sky4walk/BrausteuerungV3/BackEnd/Dokumente/BrausteuerungV3Plan.jpg

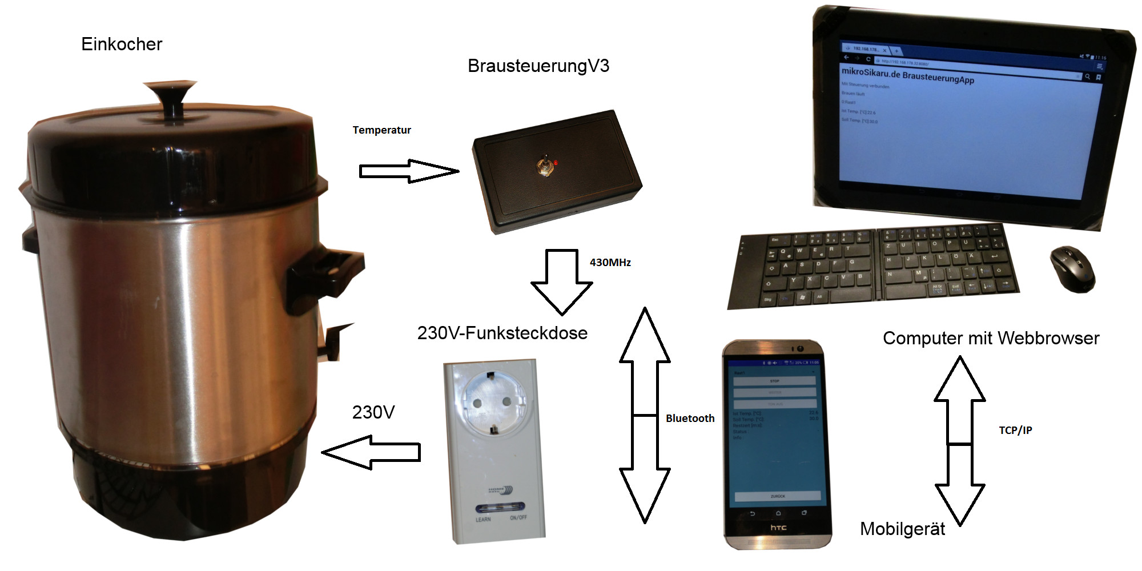
BackEnd/Dokumente/BrausteuerungV3Plan.jpg
