sky4walk/BrausteuerungV3/README.md

# BrausteuerungV3
mikroSikaru.de

brausteuerung@AndreBetz.de
 
more Information found on 
https://zwieselbrau.wordpress.com/2016/03/30/mikrosikaru-brausteuerung-v3-bluetooth/

Video Tutorial
https://zwieselbrau.wordpress.com/2017/05/13/mikrosikaru-brausteuerung-v3-bedienung-videoanleitung/

Android App in Playstore:
https://play.google.com/store/apps/details?id=de.mikrosikaru.brausteuerungapp
