sky4walk/BrausteuerungV3/FrontEnd/Android/Dokumente/Information.odt

Lieber Kunde,

vielen Dank für den Erwerb der mikroSikaru Brausteuerung V3.

Damit Sie die Brausteuerung zufriedenstellend verwenden können, ist ein Blick in die Anleitung unumgänglich. Diese ist unter der Webseite brausteuerung.com verfügbar.

Zum Betrieb der Brausteuerung ist eine App für Android Mobilgeräte notwendig. Der Link zu der App befindet sich auch unter dem Link brausteuerung.com.

Bitte beachten Sie unbedingt auch die Anleitung ihres Android Mobilgerätes, insbesondere zur Herstellung einer Bluetooth-Verbindung.

Bei Fragen und Problemen wenden Sie sich bitte an support@mikroSikaru.de .

Mit freundlichen Grüssen

André Betz
