sky4walk/BrausteuerungV3/BackEnd/Typenschild/Typenschild.pdf

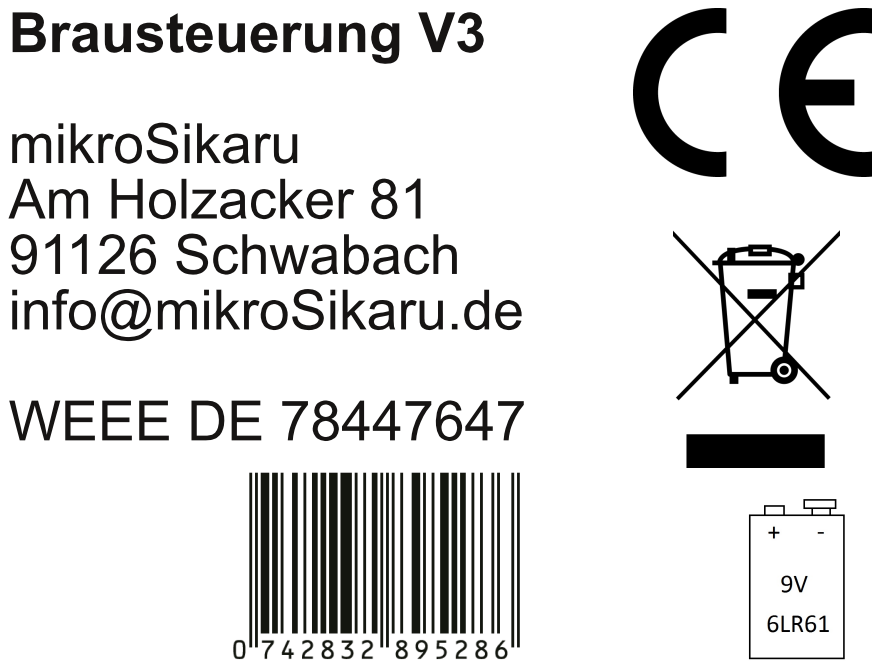
[picture p14: page 1]
