sky4walk/BrausteuerungV3/BackEnd/Arduino/Hardware/Brausteuerung_Steckplatine.png

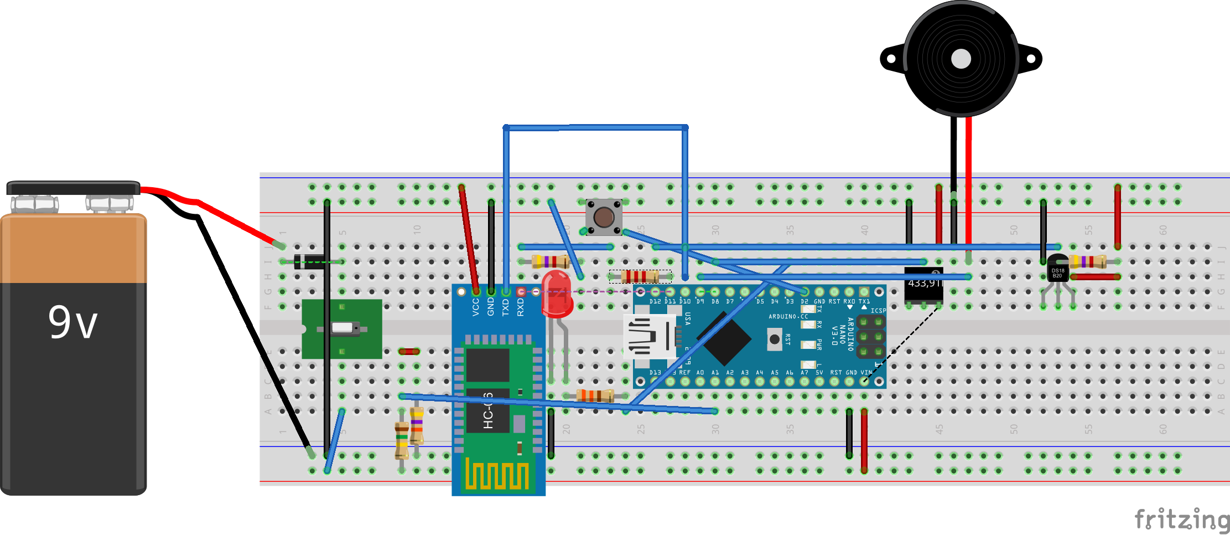
BackEnd/Arduino/Hardware/Brausteuerung_Steckplatine.png
