sky4walk/BrausteuerungV3/BackEnd/Box/BrausteuerungBox.png

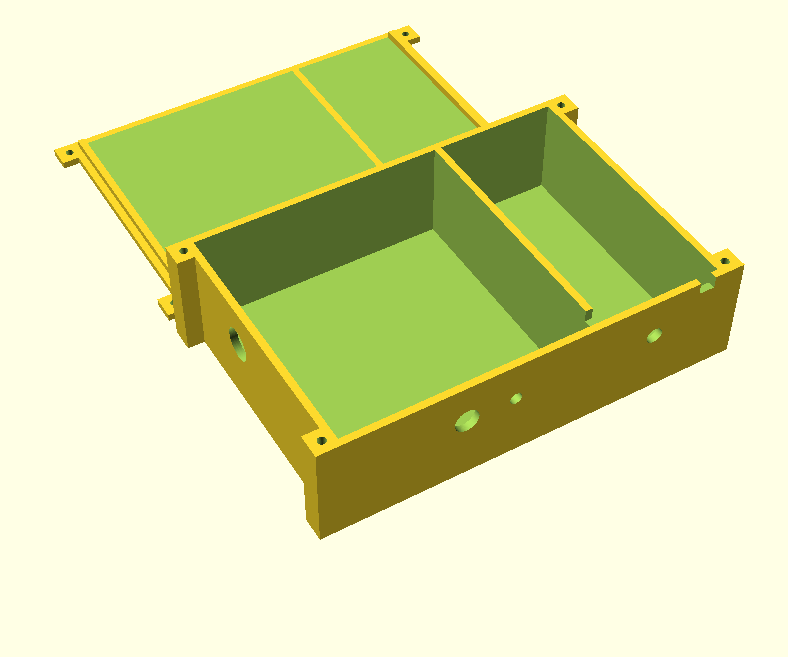
BackEnd/Box/BrausteuerungBox.png
