sky4walk/BrausteuerungV3/BackEnd/KiCad/Elecrow-KicadGerber.png

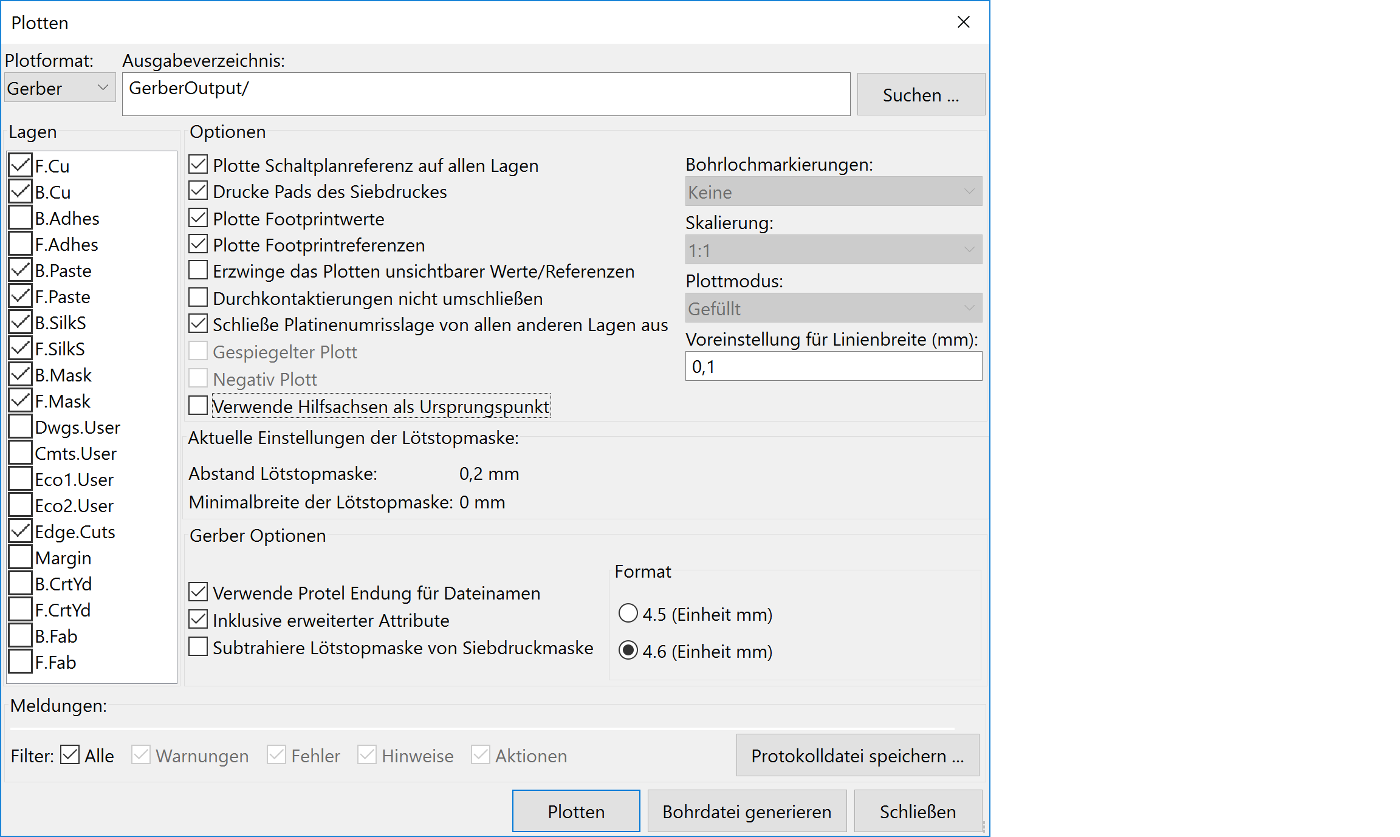
BackEnd/KiCad/Elecrow-KicadGerber.png
