sky4walk/BrausteuerungV3/BackEnd/KiCad/Elecrow-KicadGerberDrill.png

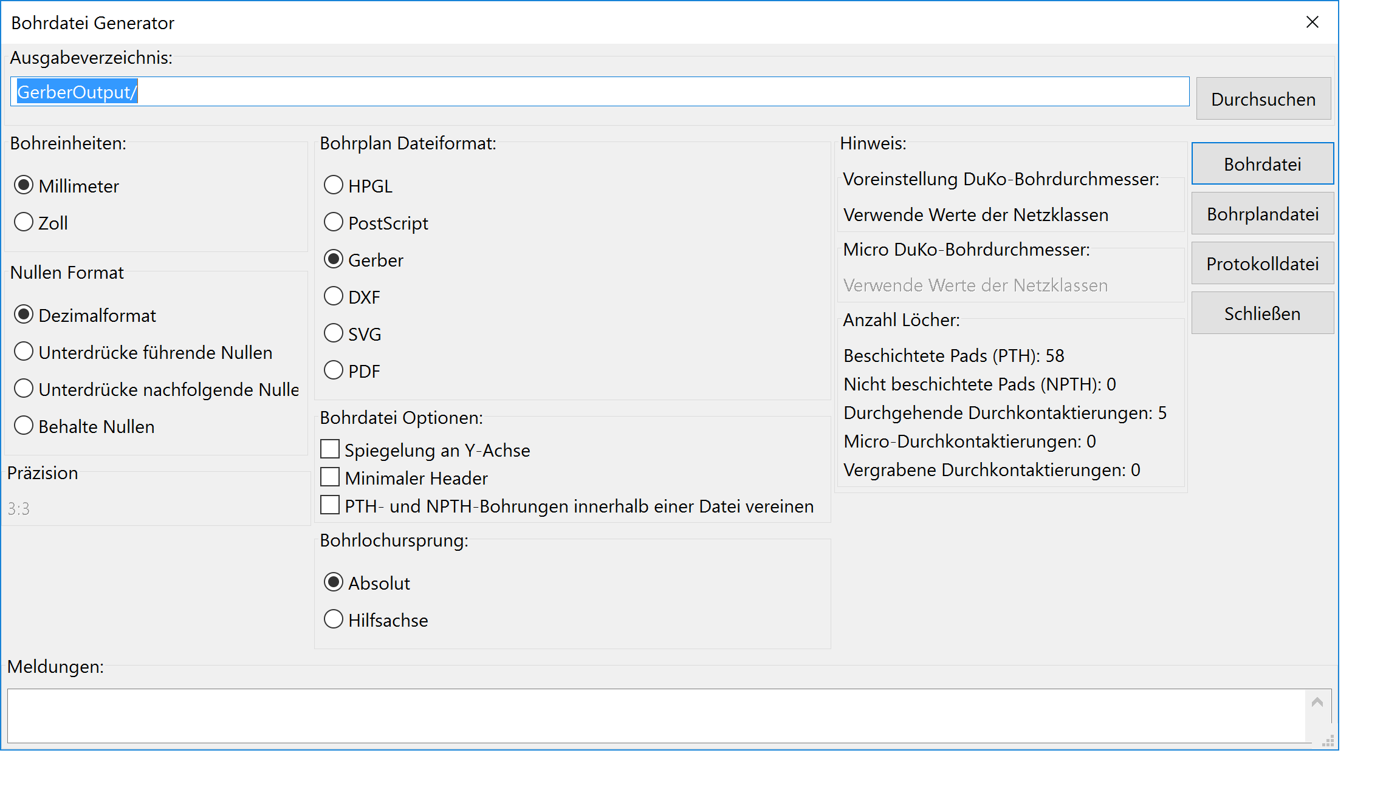
BackEnd/KiCad/Elecrow-KicadGerberDrill.png
