sky4walk/BrausteuerungV3/BackEnd/Typenschild/9VBattery.png

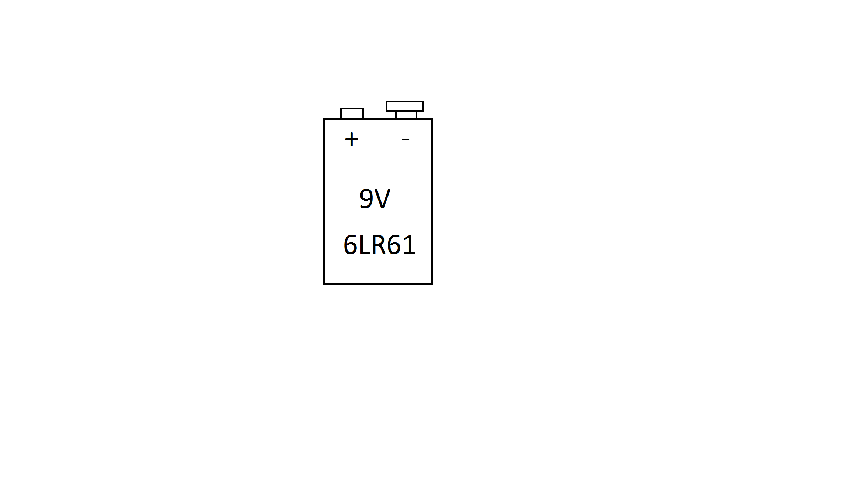
BackEnd/Typenschild/9VBattery.png
