sky4walk/BrausteuerungV3/BackEnd/Typenschild/CE.png

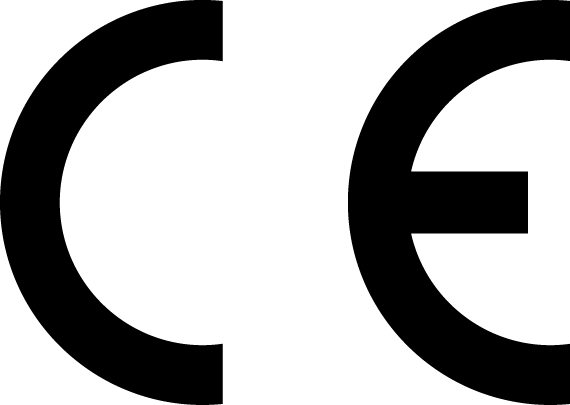
BackEnd/Typenschild/CE.png
