sky4walk/BrausteuerungV3/BackEnd/Typenschild/Muelltonne1.png

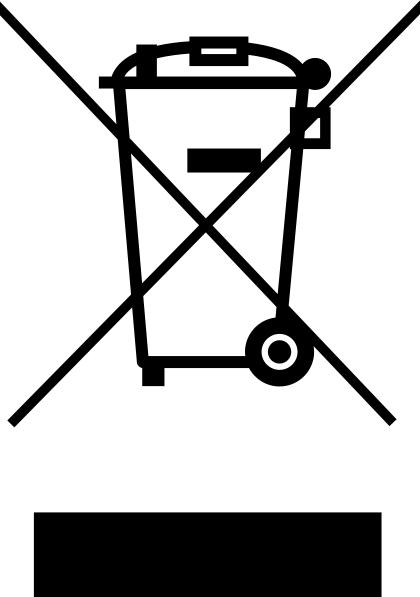
BackEnd/Typenschild/Muelltonne1.png
