sky4walk/BrausteuerungV3/BackEnd/Dokumente/Preisliste.ods

Sheet: Sheet1
Anzahl benötigt | Bezeichnung | Anbieter | Enthalten | Preis komplett | Versandkosten | Versandkosten anteilig | Preis benötigt | Preis mit Versand |  | Bestellung 7.6.16
1 | Arduino Nano | https://www.amazon.de/gp/product/B01BN1C54S/ref=oh_aui_detailpage_o07_s00?ie=UTF8&psc=1 | 5 | 17,97 | 0 | 0 | 3,594 | 3,594
1 | Bluetooth HC-06 | https://www.amazon.de/gp/product/B00GAXG9A6/ref=oh_aui_detailpage_o00_s00?ie=UTF8&psc=1 | 1 | 5,44 | 0 | 0 | 5,44 | 5,44
1 | Transmitter 433MHz | http://www.amazon.de/gp/product/B010SR8J4I?psc=1&redirect=true&ref_=oh_aui_detailpage_o09_s00 | 5 | 6,99 | 0 | 0 | 1,398 | 1,398
1 | DS18B20 wasserdicht 2Meter | https://www.amazon.de/Temperaturfuehler-Wasserdicht-Digital-Temperatur-DS18b20/dp/B01CTXWYVI | 10 | 18,85 | 0 | 0 | 1,885 | 1,885
1 | Piezzo Buzzer | http://www.amazon.de/gp/product/B00J4BK0NS?psc=1&redirect=true&ref_=oh_aui_detailpage_o00_s00 | 20 | 5,21 | 0 | 0 | 0,2605 | 0,2605
1 | Gehäuse KEMO GEH KSB 01B 101x60x26 (G01B 9V) | https://www.reichelt.de/index.html?ACTION=3;ARTICLE=73220;SEARCH=GEH%20KSB%2001B | 1 | 1,65 | 4,99 | 4,99 | 1,65 | 6,64
1 | 9V Batterieclip | http://www.amazon.de/gp/product/B00HUH9IWM | 20 | 2,65 | 0 | 0 | 0,1325 | 0,1325
1 | Widerstand 150kOhm BatterieSPannungsteiler | https://www.amazon.de/gp/product/B00I9YY6GS/ref=ox_sc_act_title_2?ie=UTF8&psc=1&smid=A18RZZ15309PCR | 20 | 1,29 | 1,99 | 0,0995 | 0,0645 | 0,164
1 | Widerstand 47kOhm BatterieSPannungsteiler | https://www.amazon.de/Widerstand-St%C3%BCck-Metallschicht-Metallfilm-Widerst%C3%A4nde/dp/B00I8SDDXW (https://www.amazon.de/Widerstand-Stück-Metallschicht-Metallfilm-Widerstände/dp/B00I8SDDXW) | 20 | 1,29 | 0 | 0 | 0,0645 | 0,0645
1 | Widerstand 330Ohm on off led | https://www.amazon.de/gp/product/B00I8NOICW/ref=ox_sc_act_title_1?ie=UTF8&psc=1&smid=A18RZZ15309PCR | 30 | 1,29 | 0 | 0 | 0,043 | 0,043
1 | Widerstand 4,7KOhm DS18B20 | http://www.amazon.de/Widerstand-St%C3%BCck-Metallschicht-Metallfilm-Widerst%C3%A4nde/dp/B00I8NOOEY | 20 | 1,29 | 0 | 0 | 0,0645 | 0,0645
1 | 1N5817 DO-41 Schottky-Gleichrichter-Dioden 20V 1A (https://www.amazon.de/gp/product/B01EZZMSKA/ref=oh_aui_detailpage_o00_s00?ie=UTF8&psc=1) | https://www.amazon.de/gp/css/order-history/ref=nav_youraccount_orders | 80 | 5,73 | 2 | 0,025 | 0,071625 | 0,096625
1 | Mini Kipp Schalter | https://www.amazon.de/gp/product/B00R1LKWCM/ref=ox_sc_act_title_1?ie=UTF8&psc=1&smid=A3JWKAKR8XB7XF | 100 | 16,07 | 0 | 0 | 0,1607 | 0,1607
1 | Home Easy Funkschaltsteckdosen HE808S | http://www.amazon.de/gp/product/B006H0XNFQ?psc=1&redirect=true&ref_=oh_aui_detailpage_o05_s00 | 3 | 31,45 | 0 | 0 | 10,4833333333333 | 10,4833333333333
1 | 10 x Kabeldurchführungstülle, Gummitülle, Kabeltülle, Kabelschutz, KD: 4mm ID: 6,2mm | https://www.amazon.de/10-Kabeldurchf%C3%BChrungst%C3%BClle-Gummit%C3%BClle-Kabelt%C3%BClle-Kabelschutz/dp/B00P8ZUQ8I | 10 | 1,99 | 2,5 | 0,25 | 0,199 | 0,449
0,1 | Sekundenkleber | http://www.amazon.de/gp/product/B00M94A20I?keywords=sekundenkleber&qid=1449411101&ref_=sr_ph&sr=1 | 5 | 2,79 | 1 | 0,02 | 0,0558 | 0,2558
0,002 | Draht schwarz (keine versandkosten schon oben) | http://www.amazon.de/Farbige-Kupferschaltlitze-Isolierung-1adrig-Farbe/dp/B0019R2WFE?s=diy | 10 | 3,03 | 0 | 0 | 0,000606 | 0,000606
0,002 | Draht rot (keine versandkoste schon oben drin) | http://www.amazon.de/Farbige-Kupferschaltlitze-Isolierung-1adrig-Farbe/dp/B0019R2WFE?s=diy | 10 | 3,03 | 0 | 0 | 0,000606 | 0,100606
0,1 | Lötzinn | http://www.amazon.de/Silverline-AS15-L%C3%B6tzinn-100-g/dp/B000LFTN1G?s=diy | 100 | 4,73 | 0 | 0 | 0,00473 | 0,00473
1 | LED als Power on indikator | http://www.amazon.de/Green-Yellow-Assorted-Emitting-Diodes/dp/B0087ZT1VO | 75 | 2,35 | 0 | 0 | 0,0313333333333 | 0,0313333333333
1 | DIP-4 Drucktaster 6x6x5mm DC12V 50mA | https://www.amazon.de/gp/product/B00D82M9LA/ref=oh_aui_search_detailpage?ie=UTF8&psc=1 | 100 | 1,28 | 1 | 0,01 | 0,0128 | 0,0228
0,001 | Isolierband - Länge 25mt. - Breite 15mm. - Schwarz | https://www.amazon.de/Isolierband-L%C3%A4nge-25mt-Breite-Schwarz/dp/B00EAQPH2Q?s=diy | 25 | 4,4 | 0 | 0 | 0,000176 | 0,000176
1 | Platine | elecrow.com | 10 | 14 | 8 | 0,8 | 1,4 | 2,2
1 | Typenschild | Wir-machen-druck.de | 75 | 12,9 | 3,9 | 0,052 | 0,172 | 0,224
33,33 | Papier (Rechnung+Bedienungsanleitung + Versandetikett) | https://www.amazon.de/Hewlett-Packard-CHP350-Laserpapier-HP-Colour-Laser-Blatt/dp/B000H80CXA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 | 500 | 8,66 | 0 | 0 | 0,5772756 | 0,5772756
1 | Versand DHL Versichert 2kg | dhl.de | 1 | 4,99 | 0 | 0 | 4,99 | 4,99
 | Summe |  |  |  | 25,38 | 6,2465 | 32,7564852666667 | 39,2829852666667
 | Kosten ProfiCook |  |  |  |  |  |  | 9,7103753333333
 |  |  |  |  |  |  |  |  | 0
 |  |  |  |  |  |  |  |  | 0
Aufbauschritte | Zeiten (min)
Bauteile darauflöten | 10
Bohren Gehäuse | 5
Zusammenbau Gehäuse | 10
Verpacken | 12
einstellen / einlernen / testen | 10
Summe | 47

Sheet: Blatt1
Anzahl benötigt | Bezeichnung | Anbieter | Enthalten | Preis komplett | Versandkosten | Versandkosten anteilig | Preis benötigt | Preis mit Versand
0 | Arduino Nano | http://www.amazon.de/gp/product/B013EEPAE4?psc=1&redirect=true&ref_=oh_aui_detailpage_o06_s00 | 5 | 15,23 | 1,99 | 0 | 0 | 0,398
1 | Bluetooth HC-06 | http://www.amazon.de/EasyWordMall-Bluetooth-Transceiver-Wireless-Arduino/dp/B00VJACCP6?s=computers | 1 | 5,59 | 0 | 0 | 5,59 | 5,59
1 | Transmitter 433MHz | http://www.amazon.de/gp/product/B010SR8J4I?psc=1&redirect=true&ref_=oh_aui_detailpage_o09_s00 | 5 | 5,99 | 0 | 0 | 1,198 | 1,198
0 | Piezzo Buzzer | http://www.amazon.de/gp/product/B00J4BK0NS?psc=1&redirect=true&ref_=oh_aui_detailpage_o00_s00 | 20 | 5,21 | 0 | 0 | 0 | 0
1 | Gehäuse KEMO GEH KSB 01B 101x60x26 (G01B 9V) | https://www.reichelt.de/index.html?ACTION=3;ARTICLE=73220;SEARCH=GEH%20KSB%2001B | 1 | 1,65 | 4,99 | 4,99 | 1,65 | 6,64
0 | 9V Batterieclip | http://www.amazon.de/gp/product/B00HUH9IWM | 20 | 2,65 | 0 | 0 | 0 | 0
0 | Widerstand 100kOhm BatterieSPannungsteiler | http://www.amazon.de/Widerstand-St%C3%BCck-Metallschicht-Metallfilm-Widerst%C3%A4nde/dp/B00I8SHUE0 | 20 | 1,29 | 1,99 | 0 | 0 | 0,0995
0 | Widerstand 330Ohm on off led | http://www.amazon.de/Widerstand-St%C3%BCck-Kohleschicht-Widerst%C3%A4nde-Resistor/dp/B00IYT10JY | 30 | 2,29 | 0 | 0 | 0 | 0
1 | Schalter | http://www.amazon.de/SODIAL-Stueck-125V-Amps-Position/dp/B00IIDY49E | 10 | 3,41 | 0 | 0 | 0,341 | 0,341
1 | Kabeldurchführungstülle, Gummitülle, Kabeltülle, Kabelschutz, KD: 3,2mm ID: 4,8mm | http://www.amazon.de/gp/product/B00P8ZTF1M?psc=1&redirect=true&ref_=oh_aui_detailpage_o01_s00 | 10 | 1,99 | 2,5 | 0,25 | 0,199 | 0,449
0 | Sekundenkleber | http://www.amazon.de/gp/product/B00M94A20I?keywords=sekundenkleber&qid=1449411101&ref_=sr_ph&sr=1 | 5 | 2,79 | 1 | 0 | 0 | 0,2
0 | Draht blau | http://www.amazon.de/Farbige-Kupferschaltlitze-Isolierung-1adrig-Farbe/dp/B0019R2WFE?s=diy | 10 | 3,03 | 2,9 | 0 | 0 | 0,29
0 | Draht schwarz (keine versandkosten schon oben) | http://www.amazon.de/Farbige-Kupferschaltlitze-Isolierung-1adrig-Farbe/dp/B0019R2WFE?s=diy | 10 | 3,03 | 0 | 0 | 0 | 0
0 | Draht rot (keine versandkoste schon oben drin) | http://www.amazon.de/Farbige-Kupferschaltlitze-Isolierung-1adrig-Farbe/dp/B0019R2WFE?s=diy | 10 | 3,03 | 0 | 0 | 0 | 0,29
0 | Lötzinn | http://www.amazon.de/Silverline-AS15-L%C3%B6tzinn-100-g/dp/B000LFTN1G?s=diy | 100 | 4,73 | 0 | 0 | 0 | 0
0 | LED als Power on indikator | http://www.amazon.de/Green-Yellow-Assorted-Emitting-Diodes/dp/B0087ZT1VO | 75 | 2,35 | 0 | 0 | 0 | 0
1 | 7x9cm Lochrasterplatte Leiterplatte Streifenraster Platine | https://www.amazon.de/7x9cm-Lochrasterplatte-Leiterplatte-Streifenraster-Platine/dp/B00HV51YIY | 10 | 4 | 0,99 | 0,099 | 0,4 | 0,499
0 | DIP-4 Drucktaster | https://www.amazon.de/gp/product/B00D82M9LA/ref=oh_aui_search_detailpage?ie=UTF8&psc=1 | 100 | 1,28 | 1 | 0 | 0 | 0,01
 | doppelseitiges klebeband
 | isolierband
 | Summe |  |  |  | 17,36 | 5,339 | 9,378 | 16,0045
0 | DS18B20 wasserdicht 3Meter | http://www.amazon.de/gp/product/B00EU5U182?psc=1&redirect=true&ref_=oh_aui_detailpage_o01_s00 | 5 | 15,99 | 0,99 | 0 | 0 | 0,198
0 | Widerstand 4,7KOhm DS18B20 | http://www.amazon.de/Widerstand-St%C3%BCck-Metallschicht-Metallfilm-Widerst%C3%A4nde/dp/B00I8NOOEY | 20 | 1,29 | 0 | 0 | 0 | 0
1 | NTC 10k 3470 | http://www.amazon.de/gp/product/B00ORLCZ8I?psc=1&redirect=true&ref_=oh_aui_detailpage_o05_s00 | 10 | 6,25 | 0 | 0 | 0,625 | 0,625
1 | Widerstand 10kOHm NTC | http://www.amazon.de/Widerstand-St%C3%BCck-Metallschicht-Metallfilm-Widerst%C3%A4nde/dp/B00I8N88MS | 20 | 1,29 | 0 | 0 | 0,0645 | 0,0645
1 | Home Easy Funkschaltsteckdosen HE808S | http://www.amazon.de/gp/product/B006H0XNFQ?psc=1&redirect=true&ref_=oh_aui_detailpage_o05_s00 | 3 | 30 | 0 | 0 | 10 | 10
 | Kosten NTC |  |  |  |  |  |  | 26,694
 | Kosten DS18B20 |  |  |  |  |  |  | 26,2025
 | Kosten ProfiCook |  |  |  |  |  |  | 7,077

Sheet: Tabelle3
Anzahl benötigt | Bezeichnung | Anbieter | Enthalten | Preis komplett | Versandkosten | Versandkosten anteilig | Preis benötigt | Preis mit Versand |  |  | Bestellung 7.6.16
1 | Arduino Nano | https://www.amazon.de/gp/product/B015MGHH6Q/ref=oh_aui_detailpage_o03_s00?ie=UTF8&psc=1 | 5 | 16,99 | 0 | 0 | 3,398 | 3,398 | Produkthaftpflicht jährlich | 295
1 | Bluetooth HC-06 | https://www.amazon.de/Bluetooth-Sendeempfaenger-Modul-drahtlose-serielle/dp/B01DXFA6GQ | 1 | 4,56 | 0 | 0 | 4,56 | 4,56 | WEEE | 350
1 | Transmitter 433MHz | https://www.amazon.de/XCSOURCE-Transmitter-Receiver-Arduino-TE122/dp/B00V4ISS38 | 5 | 6,89 | 0 | 0 | 1,378 | 1,378 |  | 645
1 | DS18B20 wasserdicht 2Meter | https://www.amazon.de/Temperaturfuehler-Wasserdicht-Digital-Temperatur-DS18b20/dp/B01CTXWYVI | 10 | 19,66 | 0 | 0 | 1,966 | 1,966
1 | Piezzo Buzzer 3V , d=12mm, Dicke=9,6mm | http://www.amazon.de/gp/product/B00J4BK0NS?psc=1&redirect=true&ref_=oh_aui_detailpage_o00_s00 | 20 | 5,21 | 0 | 0 | 0,2605 | 0,2605
1 | Gehäuse KEMO GEH KSB 01B 101x60x26 (G01B 9V) | https://www.reichelt.de/index.html?ACTION=3;ARTICLE=73220;SEARCH=GEH%20KSB%2001B | 30 | 1,65 | 4,99 | 0,1663333333333 | 0,055 | 0,2213333333333
1 | 9V Batterieclip | http://www.amazon.de/gp/product/B00HUH9IWM | 20 | 2,65 | 0 | 0 | 0,1325 | 0,1325
1 | Widerstand 150kOhm BatterieSPannungsteiler | https://www.amazon.de/gp/product/B00I9YY6GS/ref=ox_sc_act_title_2?ie=UTF8&psc=1&smid=A18RZZ15309PCR | 20 | 1,29 | 1,99 | 0,0995 | 0,0645 | 0,164
1 | Widerstand 47kOhm BatterieSPannungsteiler | https://www.amazon.de/Widerstand-St%C3%BCck-Metallschicht-Metallfilm-Widerst%C3%A4nde/dp/B00I8SDDXW (https://www.amazon.de/Widerstand-Stück-Metallschicht-Metallfilm-Widerstände/dp/B00I8SDDXW) | 20 | 1,29 | 0 | 0 | 0,0645 | 0,0645
1 | Widerstand 330Ohm on off led | https://www.amazon.de/gp/product/B00I8NOICW/ref=ox_sc_act_title_1?ie=UTF8&psc=1&smid=A18RZZ15309PCR | 30 | 1,29 | 0 | 0 | 0,043 | 0,043
2 | Widerstand 4,7KOhm DS18B20 | http://www.amazon.de/Widerstand-St%C3%BCck-Metallschicht-Metallfilm-Widerst%C3%A4nde/dp/B00I8NOOEY | 20 | 1,29 | 0 | 0 | 0,129 | 0,129
1 | Widerstand 2,2KOhm HC06 RX | https://www.amazon.de/gp/product/B00SWKCU62/ref=ox_sc_act_title_1?smid=A50DZI580G3JX&psc=1 | 30 | 3,68 | 0 | 0 | 0,1226666666667 | 0,1226666666667
1 | 1N5817 DO-41 Schottky-Gleichrichter-Dioden 20V 1A (https://www.amazon.de/gp/product/B01EZZMSKA/ref=oh_aui_detailpage_o00_s00?ie=UTF8&psc=1) | https://www.amazon.de/gp/css/order-history/ref=nav_youraccount_orders | 80 | 5,73 | 2 | 0,025 | 0,071625 | 0,096625
1 | 10 x Kippschalter mit 2 Positionen, AC, 125 V / 3 A 2.8 x 1.2 x 0.5cm / 1.1 "x 0.5" x 0.2 "(L * B * H) (https://www.amazon.de/gp/product/B00HGAKDIQ/ref=oh_aui_detailpage_o01_s00?ie=UTF8&psc=1) | https://www.amazon.de/gp/product/B00HGAKDIQ/ref=oh_aui_detailpage_o01_s00?ie=UTF8&psc=1 | 10 | 5,09 | 0 | 0 | 0,509 | 0,509
1 | Arendo - Funksteckdosen-Set (3+1) | https://www.amazon.de/gp/product/B01GQFJVC0/ref=oh_aui_detailpage_o04_s00?ie=UTF8&psc=1 | 3 | 16,85 | 0 | 0 | 5,6166666666667 | 5,6166666666667
1 | 10 x Kabeldurchführungstülle, Gummitülle, Kabeltülle, Kabelschutz, KD: 4mm ID: 6,2mm | https://www.amazon.de/10-Kabeldurchf%C3%BChrungst%C3%BClle-Gummit%C3%BClle-Kabelt%C3%BClle-Kabelschutz/dp/B00P8ZUQ8I | 10 | 1,99 | 2,5 | 0,25 | 0,199 | 0,449
0,1 | Sekundenkleber | http://www.amazon.de/gp/product/B00M94A20I?keywords=sekundenkleber&qid=1449411101&ref_=sr_ph&sr=1 | 5 | 2,79 | 1 | 0,02 | 0,0558 | 0,2558
0,002 | Draht schwarz (keine versandkosten schon oben) | http://www.amazon.de/Farbige-Kupferschaltlitze-Isolierung-1adrig-Farbe/dp/B0019R2WFE?s=diy | 10 | 3,03 | 0 | 0 | 0,000606 | 0,000606
0,002 | Draht rot (keine versandkoste schon oben drin) | http://www.amazon.de/Farbige-Kupferschaltlitze-Isolierung-1adrig-Farbe/dp/B0019R2WFE?s=diy | 10 | 3,03 | 0 | 0 | 0,000606 | 0,100606
0,1 | Lötzinn | http://www.amazon.de/Silverline-AS15-L%C3%B6tzinn-100-g/dp/B000LFTN1G?s=diy | 100 | 4,73 | 0 | 0 | 0,00473 | 0,00473
1 | LED als Power on indikator | http://www.amazon.de/Green-Yellow-Assorted-Emitting-Diodes/dp/B0087ZT1VO | 75 | 2,35 | 0 | 0 | 0,0313333333333 | 0,0313333333333
1 | DIP-4 Drucktaster 6x6x5mm DC12V 50mA | https://www.amazon.de/gp/product/B00D82M9LA/ref=oh_aui_search_detailpage?ie=UTF8&psc=1 | 100 | 1,28 | 1 | 0,01 | 0,0128 | 0,0228
0,001 | Isolierband - Länge 25mt. - Breite 15mm. - Schwarz | https://www.amazon.de/Isolierband-L%C3%A4nge-25mt-Breite-Schwarz/dp/B00EAQPH2Q?s=diy | 25 | 4,4 | 0 | 0 | 0,000176 | 0,000176
1 | Platine | elecrow.com | 50 | 44,48 | 23,21 | 0,4642 | 0,8896 | 1,3538
1 | Typenschild | Wir-machen-druck.de | 75 | 12,9 | 3,9 | 0,052 | 0,172 | 0,224
1 | Karton | https://www.bb-verpackungsshop.de/faltkarton-200-x-150-x-90-mm-p-36.html | 100 | 27,25 | 4,64 | 0,0464 | 0,2725 | 0,3189
2 | Papier (Rechnung+Bedienungsanleitung + Versandetikett) | https://www.amazon.de/Hewlett-Packard-CHP350-Laserpapier-HP-Colour-Laser-Blatt/dp/B000H80CXA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 | 500 | 8,66 | 0 | 0 | 0,03464 | 0,03464
1 | Versand DHL Versichert 2kg | dhl.de | 1 | 4,99 | 0 | 0 | 4,99 | 4,99
10 | 10 Stück 2,54 mm Pitch, einreihig, gerade Header 40Pins Female Stecker | https://www.amazon.de/gp/product/B00N3ZSBCS/ref=oh_aui_detailpage_o00_s00?ie=UTF8&psc=1 | 400 | 7,95 | 0 | 0 | 0,19875 | 0,19875
1 | Kabelbinder | https://www.amazon.de/GW-Kabelbinder-Technik-GT-200M-Kabelbinder-schwarz/dp/B00O0N9EXM?s=diy | 100 | 4,99 | 0 | 0 | 0,0499 | 0,0499
0,3 | BB-Verpackungen Luftpolsterfolie, 0,5 x 50 m | https://www.amazon.de/BB-Verpackungen-Luftpolsterfolie-Noppenfolie-Blisterfolie-Polstermaterial/dp/B004UEX7KC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 | 50 | 13,9 | 0 | 0 | 0,0834 | 0,0834
1 | Buchsenleiste Stiftleiste weiblich Single Reihe 10x weibliche 40 Pin PCB Kopfleiste 2,54mm | https://www.amazon.de/COM-FOUR%C2%AE-Stiftleiste-Single-weibliche-Kopfleiste/dp/B00W92M1A4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 | 10 | 7,77 | 0 | 0 | 0,777
 | Summe |  |  |  | 45,23 | 1,1334333333333 | 51,4829326666667 | 26,780233
 | Anteilig nebenkosten |  | 40 | 645 |  |  |  | 16,125
 | Wartung |  | 5 | 10 |  |  |  | 1,6666666666667
 | Arbeitskosten |  | 1 | 20 |  |  |  | 30
 |  |  |  |  |  |  | Summe | 74,5718996666667
 |  |  |  |  |  |  |  |  |  | 1290
 |  |  |  |  |  |  |  |  |  | 258
Aufbauschritte | Zeiten (min)
Bauteile darauflöten | 10
Bohren Gehäuse | 5
Zusammenbau Gehäuse | 10
Verpacken | 12
einstellen / einlernen / testen | 10
Summe | 47

Sheet: Lager
Name | Stückzahl
Gehäuse | 30
Arduino | 35
PLatinen | 50
HC06 | 30
TempSensor | 35
433MhzSender | 30
Piezzo | 35
Steckdosen | 7
schalter | 20
Widerstände | 10
Led | 20
Tüllen | 20
Dioden | 60
Karton | 50
