sky4walk/BrausteuerungV3/BackEnd/Box/BrausteuerungBox.stl

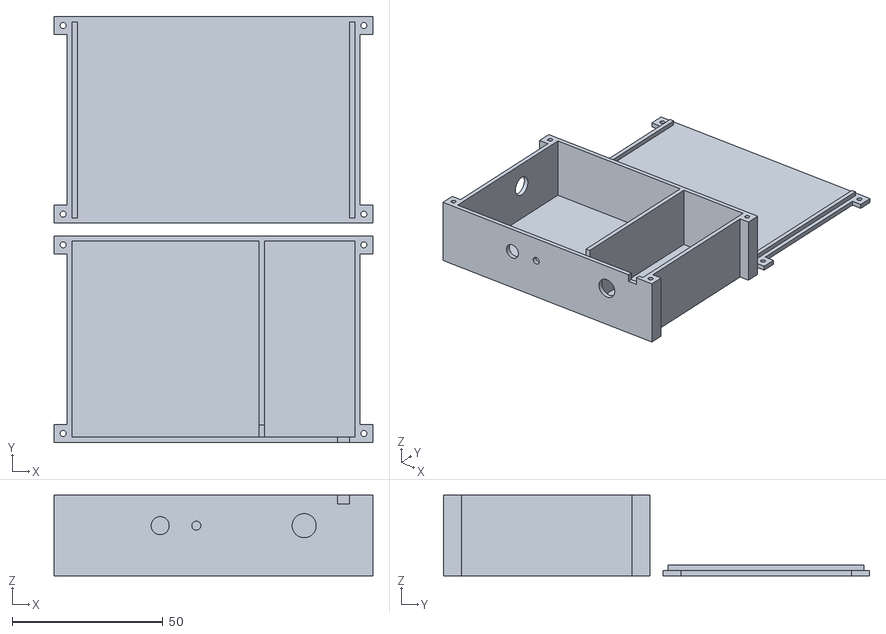
[picture p22: CAD file, 2021-12-29]
BackEnd/Box/BrausteuerungBox.stl
105.8 x 141.4 x 26.8
