sky4walk/BrausteuerungV3/BackEnd/Dokumente/BrausteuerungV3.pdf

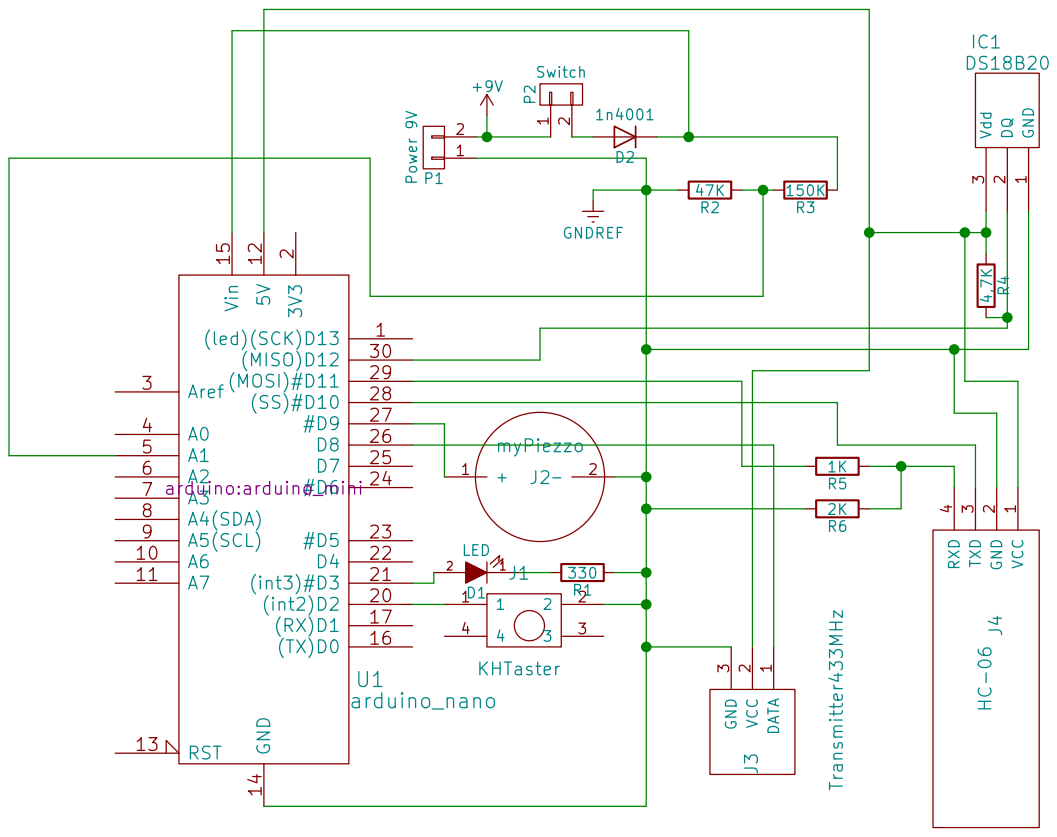
[picture p43: page 1]
