sky4walk/BrausteuerungV3/(list of files, drawings)

Other design files:
BackEnd/Arduino/Hardware/Brausteuerung.fzz
