sky4walk/BrausteuerungV3/BackEnd/KiCad/BrausteuerungV3.kicad_pcb

## KiCad design BackEnd/KiCad/BrausteuerungV3.kicad_pcb (2018-01-11)

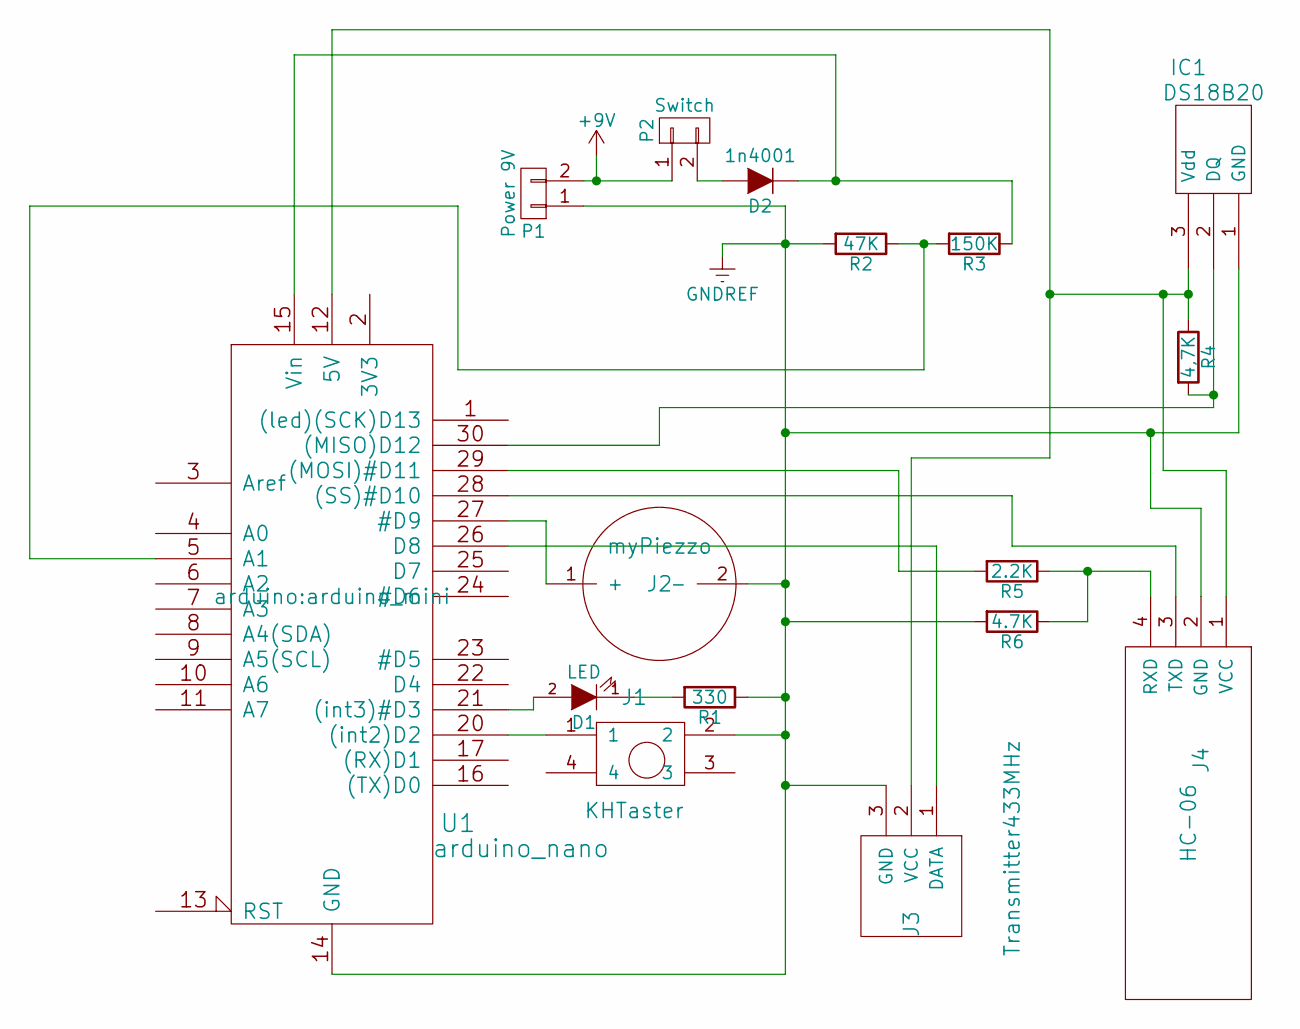
[picture p44: schematic BrausteuerungV3.sch]

Parts:
D1: LED; R_Axial_DIN0204_L3.6mm_D1.6mm_P1.90mm_Vertical
D2: 1n4001; R_Axial_DIN0207_L6.3mm_D2.5mm_P10.16mm_Horizontal
IC1: DS18B20
J1: KHTaster
J2: myPiezzo; PIEZZO
J3: Transmitter433MHz
J4: HC-06
P1: Power 9V; R_Axial_DIN0204_L3.6mm_D1.6mm_P1.90mm_Vertical
P2: Switch; R_Axial_DIN0204_L3.6mm_D1.6mm_P1.90mm_Vertical
R1: 330; R_Axial_DIN0207_L6.3mm_D2.5mm_P10.16mm_Horizontal
R2: 47K; R_Axial_DIN0207_L6.3mm_D2.5mm_P10.16mm_Horizontal
R3: 150K; R_Axial_DIN0207_L6.3mm_D2.5mm_P10.16mm_Horizontal
R4: 4,7K; R_Axial_DIN0207_L6.3mm_D2.5mm_P10.16mm_Horizontal
R5: 2.2K; R_Axial_DIN0207_L6.3mm_D2.5mm_P10.16mm_Horizontal
R6: 4.7K; R_Axial_DIN0207_L6.3mm_D2.5mm_P10.16mm_Horizontal
U1: arduino_nano; arduino_mini

Connections:
+9V: P1.2, P2.1
GND: U1.19 (GND)
GNDREF: IC1.1 (GND), J1.2, J2.2 (-), J3.3 (GND), J4.2 (GND), P1.1, R1.1, R2.2, R6.2, U1.14 (GND)
unnamed: D1.1 (K), R1.2
unnamed: D1.2 (A), U1.21 ((int3)#D3)
unnamed: D2.1 (K), R3.1, U1.15 (Vin)
unnamed: D2.2 (A), P2.2
unnamed: IC1.2 (DQ), R4.2, U1.30 ((MISO)D12)
unnamed: IC1.3 (Vdd), J3.2 (VCC), J4.1 (VCC), R4.1, U1.12 (5V)
unnamed: J1.1, U1.20 ((int2)D2)
unnamed: J2.1 (+), U1.27 (#D9)
unnamed: J3.1 (DATA), U1.26 (D8)
unnamed: J4.3 (TXD), U1.28 ((SS)#D10)
unnamed: J4.4 (RXD), R5.1, R6.1
unnamed: R2.1, R3.2, U1.5 (A1)
unnamed: R5.2, U1.29 ((MOSI)#D11)

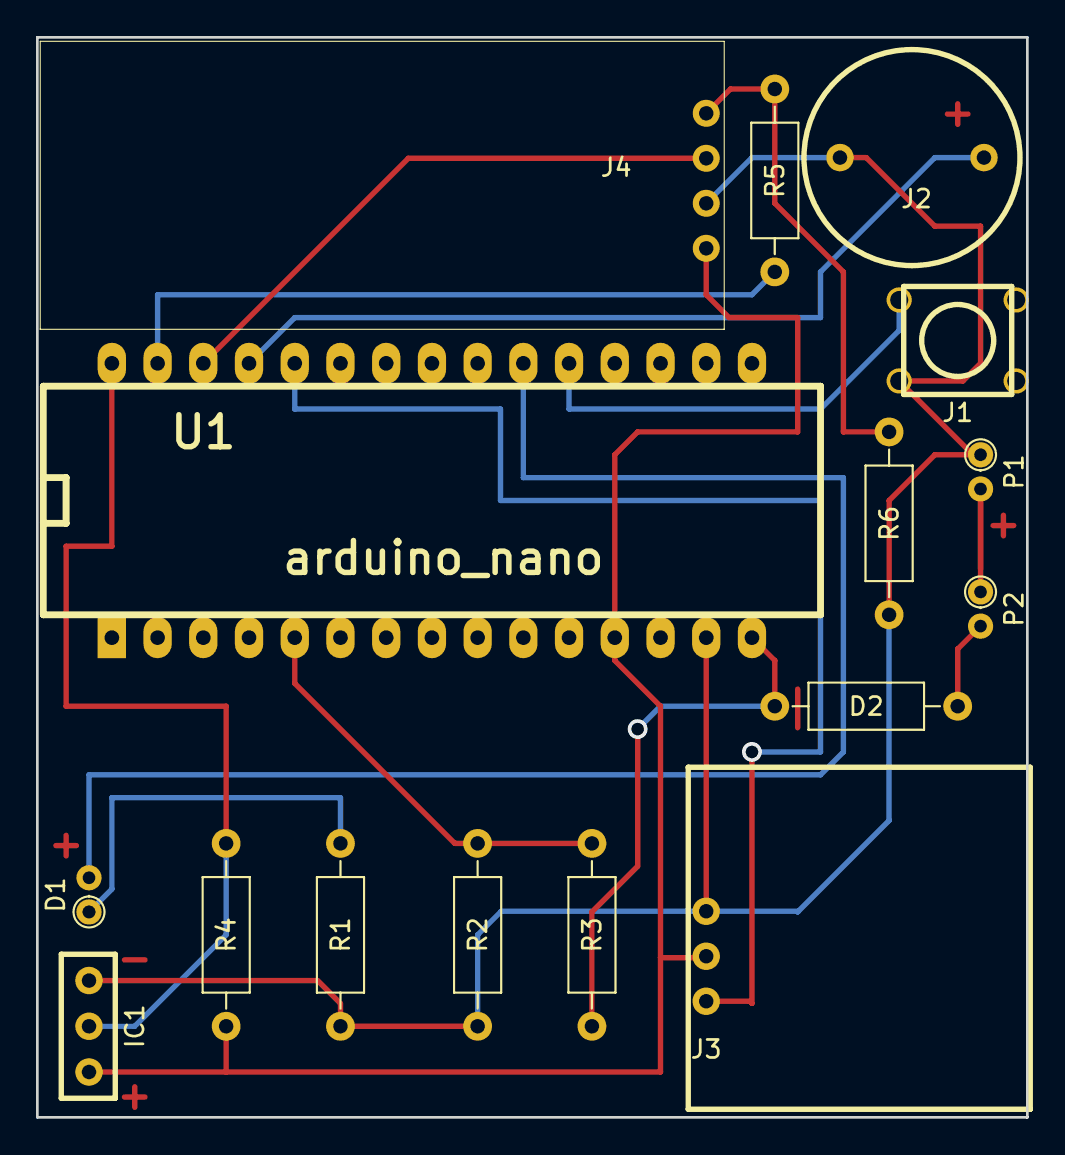
[picture p45: board BrausteuerungV3.kicad_pcb from above]

Board: 2 copper layers, 55.0 x 60.0 mm, 16 parts (0 on the bottom side), 15 nets.
