sky4walk/BrausteuerungV3/(commit log)

2016-04-25 Bier Rezepte und Manual
2016-07-25 Pils gebraut
    [BrausteuerungLog_23.07.2016.csv]
2016-12-30 changed: - temp measure timer - switch timer
2016-12-30 readme for arduino flushing new firmware
2017-01-01 Arduino: switch always off heating when not brewing Android: some thread optimizing and fixing possible race conditions
2017-01-02 added information about Windows usb2serial driver for arduino chipset
2017-01-03 driver for CH341SER
2017-01-08 bug fix: Funksignal wurde nur bei Aenderung des Heizungszustandes geändert
2017-04-13 added programm to set the Bluetooth device and App connection
2017-04-23 Rezept Fraenkisches Landbier und Brau Log
    [BrausteuerungLog_17.04.2017.csv]
2017-05-04 fehler in widerstaenden behoben und zwei neue bilder
2017-06-13 new FW because if pause bug. sometimes timer stopps
2017-06-13 neues Rezept mit Log
    [BrausteuerungLog_11.06.2017.csv]
2017-06-13 added documention - documents for building - documents for user - gerber files and kicad files for layout circuit - label document
    [Brausteuerung.fzz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]
2017-06-13 added source code: - Arduino Firmware - Android App
2017-06-22 changed calculation document
    [Berechnungen.ods, BrausteuerungLog_14.06.2017.csv]
2017-07-18 Kuehlrezept fuer Brausteuerung
    ermoeglicht damit einen Kuehlschrank zu steuern fuer die Gaerfuehrung
2017-07-24 fixed some bugs in the Android App. New Version 1.19
    [Preisliste.ods]
2017-09-10 braulog vom 10.9.17 obergaeriges Bockbier
    [BrausteuerungLog_10.09.2017.csv]
2017-09-12 overheat check only works when SollTemp is other then zero
    [Brausteuerung.ino, heatcontroler.h]
2017-09-20 calc for bottle hight
    [Berechnungen.ods]
2017-09-21 changed wort correction function
    [Berechnungen.ods]
2017-11-15 changed pricelist
    [Preisliste.ods]
2017-11-22 added female pin headers
    [Preisliste.ods]
2017-11-23 neue kippschalter
    [Preisliste.ods]
2017-11-27 added a reset when waitingvfor input
    [menu.h]
2018-01-10 added voltage devider for hc-06
    [Brausteuerung.fzz]
2018-01-10 added voltage divider KiCad
    [Brausteuerung.fzz, BrausteuerungV3.sch]
2018-01-11 added kicad layout
    [BrausteuerungV3.kicad_pcb, BrausteuerungV3.sch]
2018-01-11 gerber und borh dateien
    [BrausteuerungV3-B.Cu.gbl, BrausteuerungV3-B.Mask.gbs, BrausteuerungV3-B.Paste.gbp, BrausteuerungV3-B.SilkS.gbo, BrausteuerungV3-Edge.Cuts.gm1, BrausteuerungV3-F.Cu.gtl, BrausteuerungV3-F.Mask.gts, BrausteuerungV3-F.Paste.gtp]
2018-01-30 spannunsgteiler andere widerstandswerte
    [Brausteuerung.fzz, BrausteuerungV3.sch, Preisliste.ods]
2018-02-11 reverted to circuit without spannungsteiler HC06
    [Brausteuerung.fzz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]
2018-02-16 some HC-06 need a circuit leveler
    [BrausteuerungV3-B.Cu.gbl, BrausteuerungV3-B.Mask.gbs, BrausteuerungV3-B.Paste.gbp, BrausteuerungV3-B.SilkS.gbo, BrausteuerungV3-Edge.Cuts.gm1, BrausteuerungV3-F.Cu.gtl, BrausteuerungV3-F.Mask.gts, BrausteuerungV3-F.Paste.gtp]
2018-03-28 changed PID
2018-07-02 corrected resistor values
2018-07-21 added diode voltage for volatge measuring
2019-10-09 added buchsenleiste
    [Preisliste.ods]
2021-01-04 Box for electronix
    [BrausteuerungBox.scad, BrausteuerungBox.stl]
2021-01-04 some corrections
    [BrausteuerungBox.scad, BrausteuerungBox.stl]
2021-01-05 gradient not reseted after program change and better box design
    [BrausteuerungBox.scad, BrausteuerungBox.stl]
2021-12-29 a little bigger hole for DC connector
    [BrausteuerungBox.scad, BrausteuerungBox.stl]
2025-08-25 when temp sensor has a failure the last value is added to gradient
    [Brausteuerung.ino, sensor.h]
2025-11-22 changed error behaviour of sensor
    [sensor.h]
2025-11-24 temp val error from ds18b20 will not be hidden
    [Brausteuerung.ino, brew.h, sensor.h]
2026-01-31 bug fix sensor read out
    [sensor.h]
